sparkfun/SparkFun_Qwiic_Gas_Sensors_GM-X02B/docs/docs/Resources.md

# Resources

For more information about the SparkFun Gas Sensor - GM-XX2B (Qwiic) breakouts, take a look at the following resources:

## Schematics & Board Files

**GM-102B - Nitrogen Dioxide Gas Sensor**
* [Schematic](/ref/boards/SparkFun_Qwiic_Gas_Sensor_GM-102B.pdf)
* [KiCad Files](/ref/boards/SparkFun_Qwiic_Gas_Sensor_GM-102B.zip)

**GM-202B Ethanol & Smoke Gas Sensor**
* [Schematic](/ref/boards/SparkFun_Qwiic_Gas_Sensor_GM-202B.pdf)
* [KiCad Files](/ref/boards/SparkFun_Qwiic_Gas_Sensor_GM-202B.zip)

**GM-302B Alcohol/Ethanol Gas Sensor**
* [Schematic](/ref/boards/SparkFun_Qwiic_Gas_Sensor_GM-302B.pdf)
* [KiCad Files](/ref/boards/SparkFun_Qwiic_Gas_Sensor_GM-302B.zip)

**GM-402B Combustible Gas Sensor**
* [Schematic](/ref/boards/SparkFun_Qwiic_Gas_Sensor_GM-402B.pdf)
* [KiCad Files](/ref/boards/SparkFun_Qwiic_Gas_Sensor_GM-402B.zip)

**GM-502B VOC Gas Sensor**
* [Schematic](/ref/boards/SparkFun_Qwiic_Gas_Sensor_GM-502B.pdf)
* [KiCad Files](/ref/boards/SparkFun_Qwiic_Gas_Sensor_GM-502B.zip)

**GM-512B Bad Breath Gas Sensor**
* [Schematic](/ref/boards/SparkFun_Qwiic_Gas_Sensor_GM-512B.pdf)
* [KiCad Files](/ref/boards/SparkFun_Qwiic_Gas_Sensor_GM-512B.zip)

**GM-602B Hydrogen Sulfide Gas Sensor**
* [Schematic](/ref/boards/SparkFun_Qwiic_Gas_Sensor_GM-602B.pdf)
* [KiCad Files](/ref/boards/SparkFun_Qwiic_Gas_Sensor_GM-602B.zip)

**GM-702B Carbon Monoxide Gas Sensor**
* [Schematic](/ref/boards/SparkFun_Qwiic_Gas_Sensor_GM-702B.pdf)
* [KiCad Files](/ref/boards/SparkFun_Qwiic_Gas_Sensor_GM-702B.zip)

**GM-802B Ammonia Gas Sensor**
* [Schematic](/ref/boards/SparkFun_Qwiic_Gas_Sensor_GM-802B.pdf)
* [KiCad Files](/ref/boards/SparkFun_Qwiic_Gas_Sensor_GM-802B.zip)

## Datasheets

* [GM-102B](/ref/datasheets/GM-102B.pdf)
* [GM-202B](/ref/datasheets/GM-202B.pdf)
* [GM-302B](/ref/datasheets/GM-302B.pdf)
* [GM-402B](/ref/datasheets/GM-402B.pdf)
* [GM-502B](/ref/datasheets/GM-502B.pdf)
* [GM-512B](/ref/datasheets/GM-512B.pdf)
* [GM-602B](/ref/datasheets/GM-602B.pdf)
* [GM-702B](/ref/datasheets/GM-702B.pdf)
* [GM-802B](/ref/datasheets/GM-802B.pdf)
