sparkfun/SparkFun_Qwiic_Gas_Sensors_GM-X02B/Documents/images/GM-602B.png

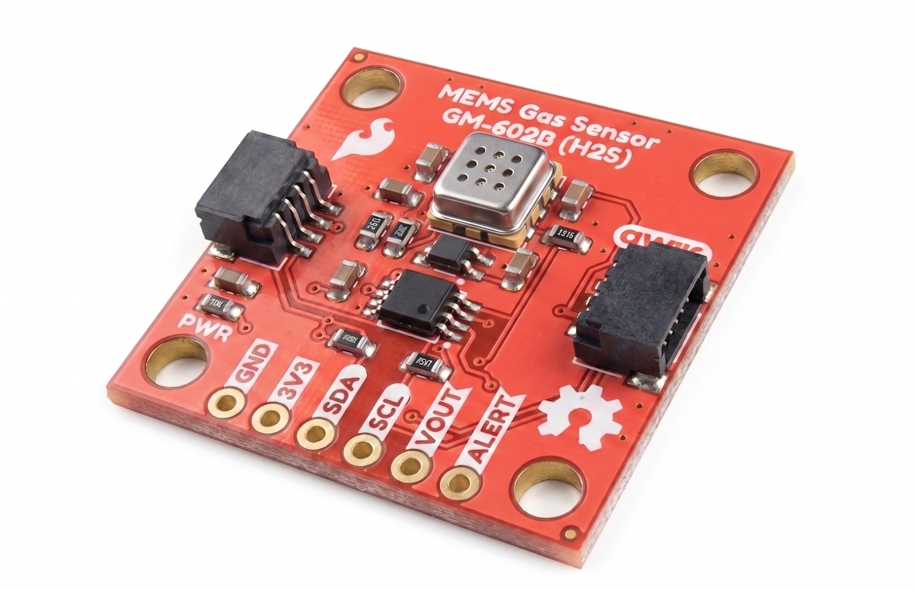
Documents/images/GM-602B.png
