sparkfun/SparkFun_Qwiic_Gas_Sensors_GM-X02B/docs/docs/hardware/hardware assembly.md

# Hardware Assembly

Now that we're familiar with all the different types of gas sensors available on these breakouts and the other hardware on the boards it's time to wire it up and start measuring gas.

## Qwiic Assembly

Since this is a Qwiic breakout, all we need to do is connect the board to a RedBoard (or other Qwiic-compatible development board) using a Qwiic cable and then connect the RedBoard to a computer over USB-C:

Photo of Qwiic Gas sensor connected to IoT RedBoard
