sparkfun/SparkFun_Qwiic_Gas_Sensors_GM-X02B/docs/static/ref/boards/SparkFun_Qwiic_Gas_Sensor_GM-402B.pdf

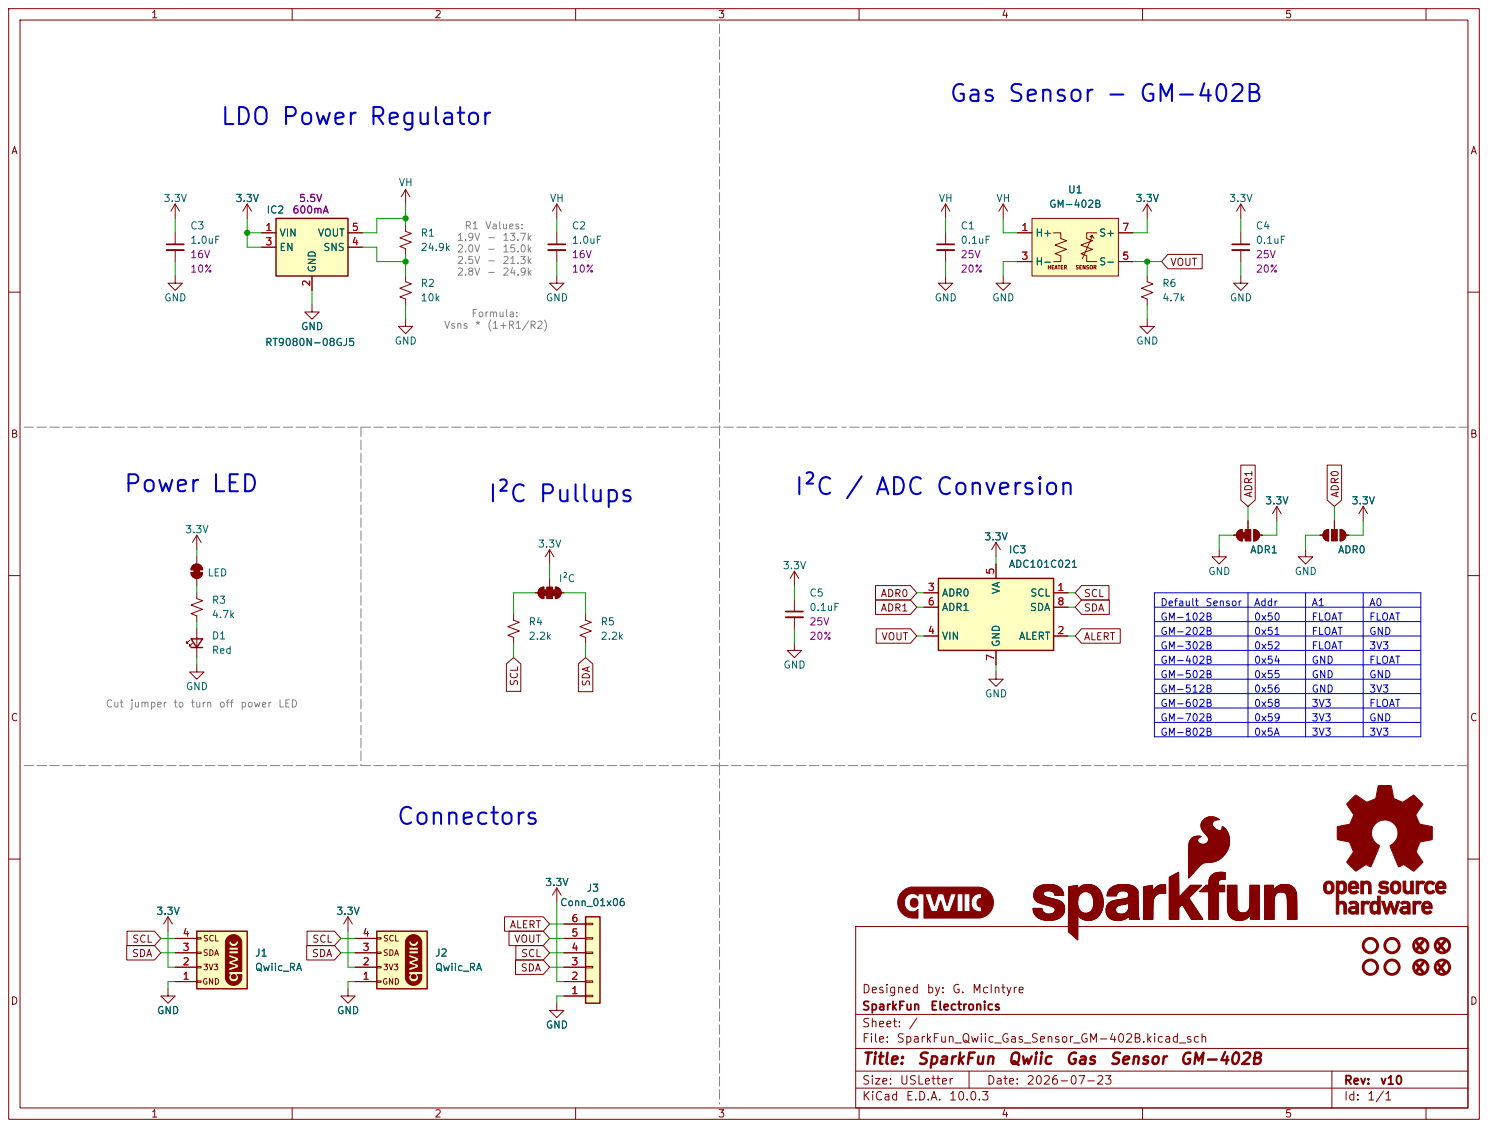
[picture p8: page 1]

VOUT SCL ALERT SDA

Designed by: G. McIntyre
SparkFun Electronics
Sheet: /
File: SparkFun_Qwiic_Gas_Sensor_GM-402B.kicad_sch
Title: SparkFun Qwiic Gas Sensor GM-402B

Size: USLetter | Rev: v10
KiCad E.D.A. 10.0.3 | Id: 1/1
