sparkfun/SparkFun_Qwiic_Gas_Sensors_GM-X02B/docs/static/ref/boards/SparkFun_Qwiic_Gas_Sensor_GM-602B.pdf

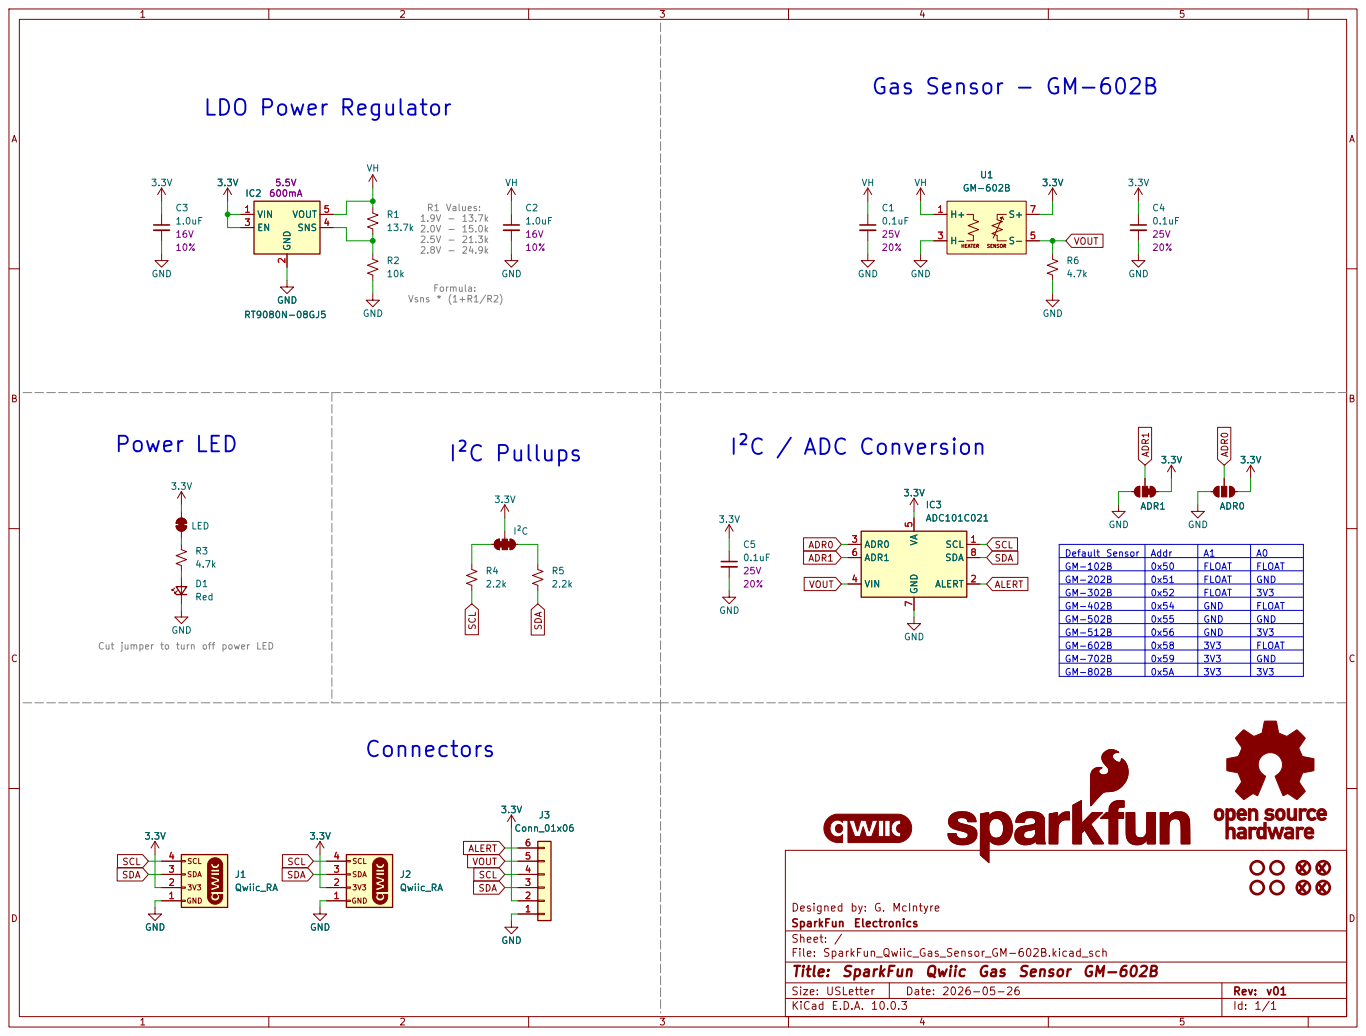
[picture p11: page 1]

Designed by: G. McIntyre
SparkFun Electronics
Sheet: /
File: SparkFun_Qwiic_Gas_Sensor_GM-602B.kicad_sch
Title: SparkFun Qwiic Gas Sensor GM-602B

Size: USLetter | Rev: v01
KiCad E.D.A. 10.0.3 | Id: 1/1
