sparkfun/SparkFun_Qwiic_Gas_Sensors_GM-X02B/(commit log)

2026-06-01 Added datasheets and updated I2C Info on schematic
2026-06-09 Updated Datasheets and PCB based on Design Review Feedback
2026-06-09 Edited back silkscreen
2026-06-11 Implemented Design Review Changes
    - Removed EN
    - Nudged Vias
    - Finalized Silkscreen
    - Updated LDO Symbol
    - Updated Resistor Values
2026-07-23 Added all Gas Sensors
2026-08-19 Updated Final versions of Gas Sensor PCBs
2026-11-12 Changed 1.9V Net to VH (Heater Voltage)
