sparkfun/SparkFun_Qwiic_Gas_Sensors_GM-X02B/Hardware/GM-402B/SparkFun_Qwiic_Gas_Sensor_GM-402B.kicad_pcb

## KiCad design Hardware/GM-402B/SparkFun_Qwiic_Gas_Sensor_GM-402B.kicad_pcb (2026-11-12)

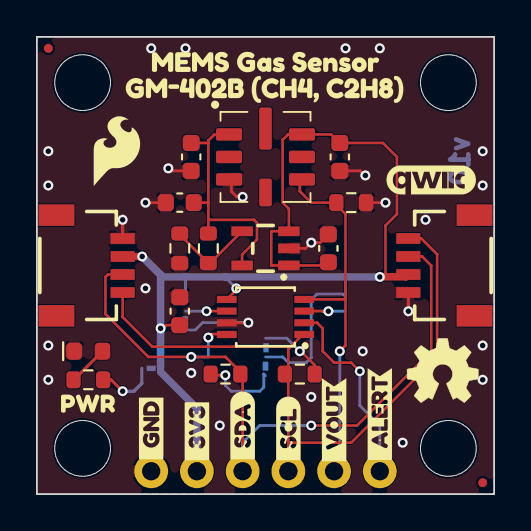
[picture p1: board SparkFun_Qwiic_Gas_Sensor_GM-402B.kicad_pcb from above]

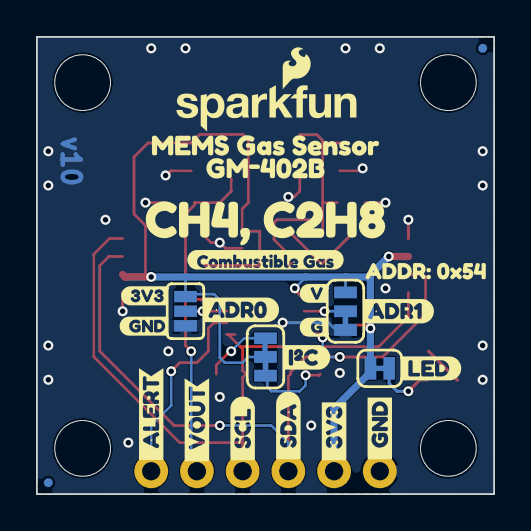
[picture p2: board SparkFun_Qwiic_Gas_Sensor_GM-402B.kicad_pcb from below]

Board: 2 copper layers, 25.4 x 25.4 mm, 60 parts (25 on the bottom side), 14 nets.

Parts:
C1, C4, C5: 0.1uF; C_0603_1608Metric
C2, C3: 1.0uF; C_0603_1608Metric
D1: Red; LED_0603_1608Metric_Red
FID1, FID2, FID3, FID4: Fiducial_0.5mm; Fiducial_0.5mm_Mask1mm
G4: OSHW_Logo; Creative_Commons_License
IC2: RT9080N-08GJ5; SOT23-5
IC3: ADC101C021; TSSOP-8_3x3mm_P0.65mm
J1, J2: Qwiic_RA; JST_1x04_P1.0mm_Horizontal_SMD
J3: Conn_01x06; 1x06_P2.54mm
JP1: LED; Jumper_2_NC_Trace
JP2: I²C; Jumper_3_NC-2_Trace
JP3: ADR0; Jumper_3_NO
JP4: ADR1; Jumper_3_NC-1_Trace
R1: 24.9k; R_0603_1608Metric
R2: 10k; R_0603_1608Metric
R3, R6: 4.7k; R_0603_1608Metric
R4, R5: 2.2k; R_0603_1608Metric
Ref**: Val**; OSHW_Logo_4mm
ST1, ST2, ST3, ST4: Standoff
U1: GM-402B; GM-X02
kibuzzard-6A2AF6B9: G***; kibuzzard-6A2AF6B9
kibuzzard-6A2AF6DB: G***; kibuzzard-6A2AF6DB
kibuzzard-6A2AF770: G***; kibuzzard-6A2AF770
kibuzzard-6A2AF782: G***; kibuzzard-6A2AF782
kibuzzard-6A7E2AAD: G***; kibuzzard-6A7E2AAD
kibuzzard-6A15EF4F, kibuzzard-6A15EF4F#2: G***; kibuzzard-6A15EF4F
kibuzzard-6A285C8F: G***; kibuzzard-6A285C8F
kibuzzard-6A285C86: G***; kibuzzard-6A285C86
kibuzzard-6A285C96: G***; kibuzzard-6A285C96
kibuzzard-6A285CA0: G***; kibuzzard-6A285CA0
kibuzzard-6A0365C6: G***; kibuzzard-6A0365C6
kibuzzard-6A6283AE: G***; kibuzzard-6A6283AE
kibuzzard-6A6283BC: G***; kibuzzard-6A6283BC
kibuzzard-6A62839A: G***; kibuzzard-6A62839A
kibuzzard-6A285721: G***; kibuzzard-6A285721
kibuzzard-6A285731: G***; kibuzzard-6A285731
kibuzzard-6A628392: G***; kibuzzard-6A628392
kibuzzard-689A66E2: G***; kibuzzard-689A66E2
kibuzzard-689A66E9: G***; kibuzzard-689A66E9
kibuzzard-689A66EE: G***; kibuzzard-689A66EE
kibuzzard-689A66F4: G***; kibuzzard-689A66F4
kibuzzard-689A642E: G***; kibuzzard-689A642E
kibuzzard-689A6711: G***; kibuzzard-689A6711
kibuzzard-689A6718: G***; kibuzzard-689A6718
kibuzzard-689A6721: G***; kibuzzard-689A6721
kibuzzard-689A6728: G***; kibuzzard-689A6728
kibuzzard-689A6796: G***; kibuzzard-689A6796

Connections:
3.3V: C3.1, C4.1, C5.1, IC2.1 (VIN), IC2.3 (EN), IC3.5 (VA), J1.2, J2.2, J3.2, JP1.2 (B), JP2.2 (B), JP3.1 (A), JP4.3 (C), U1.7 (S+)
ADR0: IC3.3 (ADR0), JP3.2 (B)
ADR1: IC3.6 (ADR1), JP4.2 (B)
ALERT: IC3.2 (ALERT), J3.6
GND: C1.2, C2.2, C3.2, C4.2, C5.2, D1.1 (K), IC2.2 (GND), IC3.7 (GND), J1.1, J2.1, J3.1, JP3.3 (C), JP4.1 (A), R2.1, R6.1, U1.3 (H-)
unnamed: D1.2 (A), R3.1
unnamed: IC2.4 (SNS), R1.1, R2.2
unnamed: JP1.1 (A), R3.2
unnamed: JP2.1 (A), R5.2
unnamed: JP2.3 (C), R4.2
SCL: IC3.1 (SCL), J1.4, J2.4, J3.4, R4.1
SDA: IC3.8 (SDA), J1.3, J2.3, J3.3, R5.1
VH: C1.1, C2.1, IC2.5 (VOUT), R1.2, U1.1 (H+)
VOUT: IC3.4 (VIN), J3.5, R6.2, U1.5 (S-)
