sparkfun/SparkFun_Qwiic_Gas_Sensors_GM-X02B/(notices)

Notices in the files:
parts and their libraries:
Released under the Creative Commons Attribution Share-Alike 4.0 License
https://creativecommons.org/licenses/by-sa/4.0
